emilianoagostini14/Sistema-de-Monitoreo-Electronico-para-Vehiculos/README.md

# Sistema-de-Monitoreo-Electronico-para-Vehiculos
Este repositorio contendrá los programas, archivos y diseños del proyecto integrador Sistema de Monitoreo Electronico  para Vehiculos
