emilianoagostini14/Sistema-de-Monitoreo-Electronico-para-Vehiculos/Diseños 3D/Tapa.SLDPRT

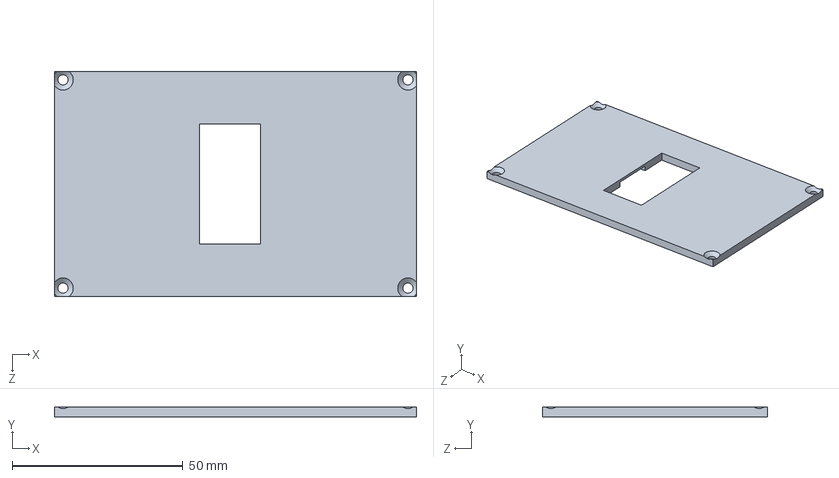
[picture p16: CAD file, 2025-11-07]
Diseños 3D/Tapa.SLDPRT
106.0 x 3.00 x 66.0 mm
