emilianoagostini14/Sistema-de-Monitoreo-Electronico-para-Vehiculos/Diseños 3D/Base.SLDPRT

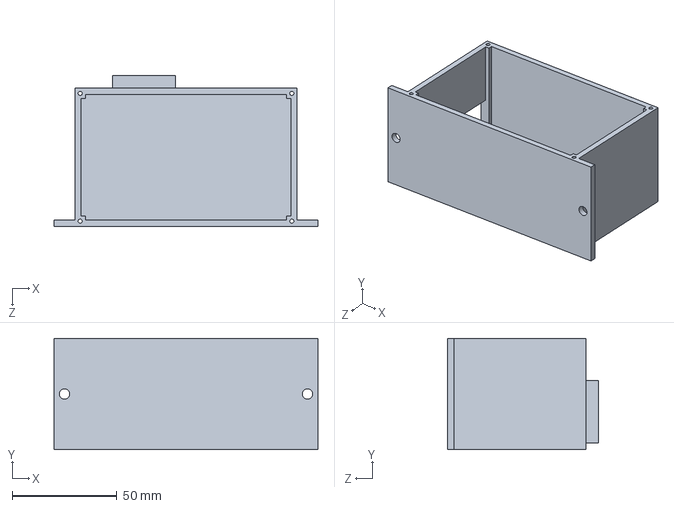
[picture p17: CAD file, 2025-11-07]
Diseños 3D/Base.SLDPRT
126.0 x 53.0 x 72.0 mm
