emilianoagostini14/Sistema-de-Monitoreo-Electronico-para-Vehiculos/(list of files, drawings)

Other design files:
Simulaciones/simulacionAdaptacionDeVoltaje.ms14
