emilianoagostini14/Sistema-de-Monitoreo-Electronico-para-Vehiculos/PCB/PCB-SistemaDeMonitoreVehicular/PCB-SistemaDeMonitoreVehicular.kicad_pcb

## KiCad design PCB/PCB-SistemaDeMonitoreVehicular/PCB-SistemaDeMonitoreVehicular.kicad_pcb (2025-11-07)

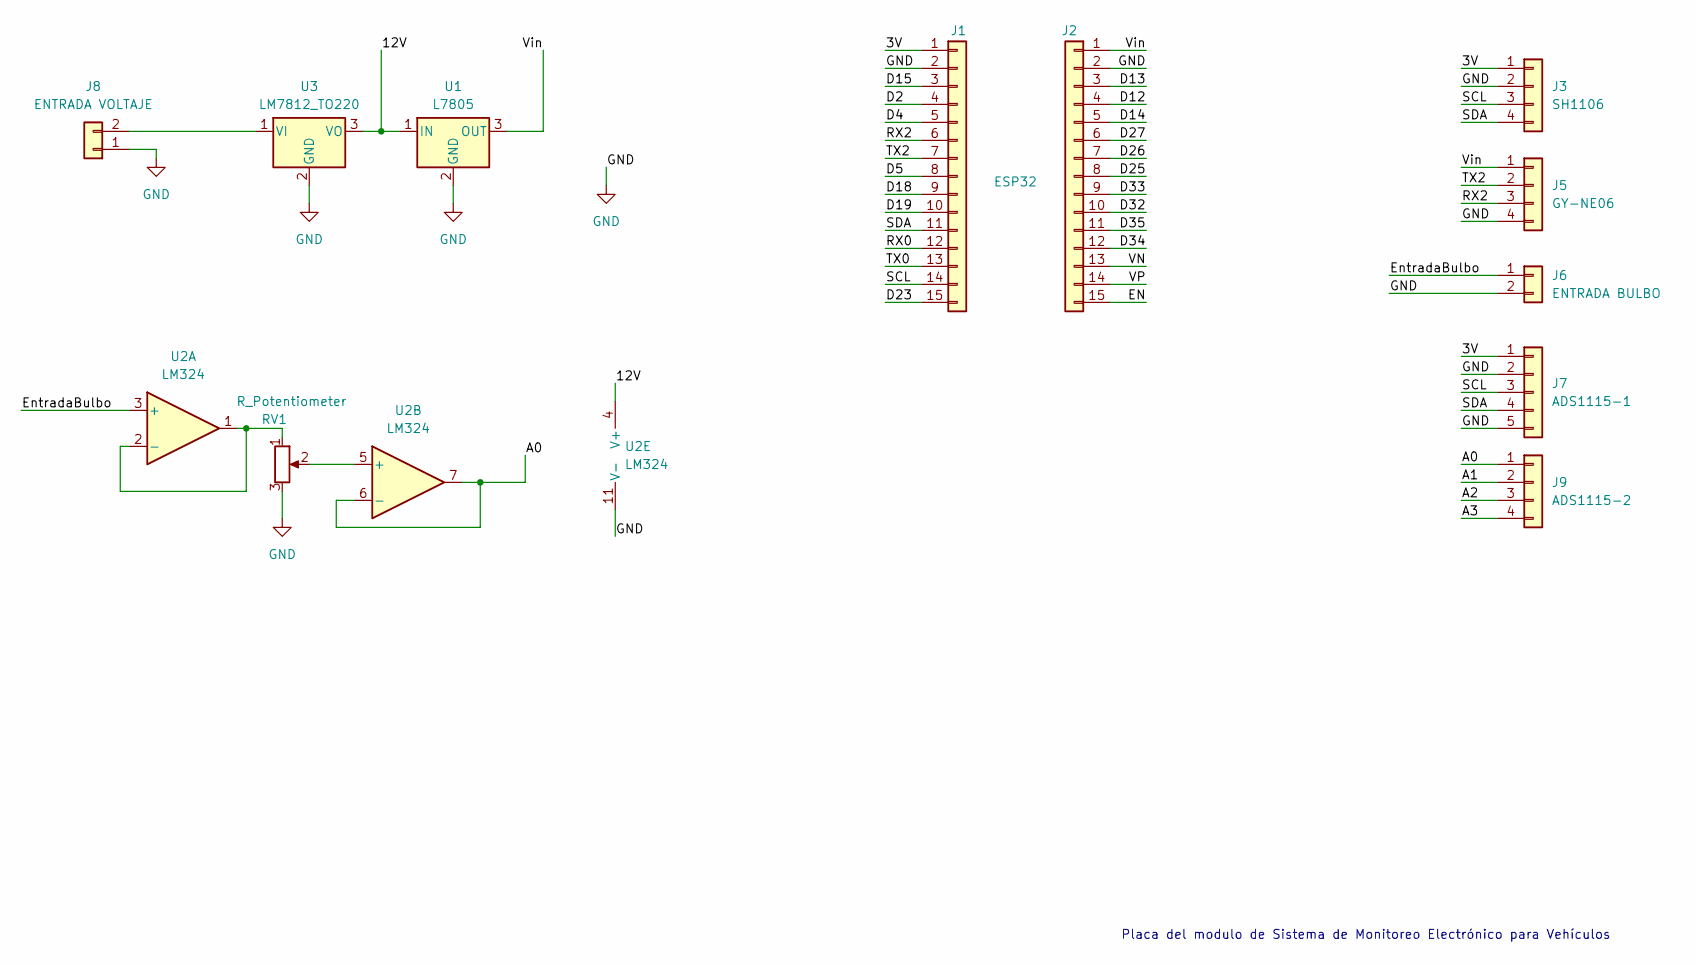
[picture p18: schematic PCB-SistemaDeMonitoreVehicular.kicad_sch]

Parts:
J1: ESP32; PinHeader_1x15_P2.54mm_Vertical
J2: Conn_01x15; PinHeader_1x15_P2.54mm_Vertical
J3: SH1106; PinHeader_1x04_P2.54mm_Vertical
J5: GY-NE06; PinHeader_1x04_P2.54mm_Vertical
J6: ENTRADA BULBO; TerminalBlock_bornier-2_P5.08mm
J7: ADS1115-1; PinHeader_1x05_P2.54mm_Vertical
J8: ENTRADA VOLTAJE; TerminalBlock_bornier-2_P5.08mm
J9: ADS1115-2; PinHeader_1x04_P2.54mm_Vertical
RV1: R_Potentiometer; Potentiometer_Bourns_3296W_Vertical
U1: L7805; TO-220-3_Vertical
U2: LM324; DIP-14_W10.16mm_LongPads
U3: LM7812_TO220; TO-220-3_Vertical

Connections:
/3V: J1.1, J3.1, J7.1
/12V: U1.1 (IN), U2.4 (V+), U3.3 (VO)
/A0: J9.1, U2.6 (-), U2.7
/A1: J9.2
/A2: J9.3
/A3: J9.4
/D2: J1.4
/D4: J1.5
/D5: J1.8
/D12: J2.4
/D13: J2.3
/D14: J2.5
/D15: J1.3
/D18: J1.9
/D19: J1.10
/D23: J1.15
/D25: J2.8
/D26: J2.7
/D27: J2.6
/D32: J2.10
/D33: J2.9
/D34: J2.12
/D35: J2.11
/EN: J2.15
/EntradaBulbo: J6.1, U2.3 (+)
/GND: J1.2, J2.2, J3.2, J5.4, J6.2, J7.2, J7.5, J8.1, RV1.3, U1.2 (GND), U2.11 (V-), U3.2 (GND)
/RX0: J1.12
/RX2: J1.6, J5.3
/SCL: J1.14, J3.3, J7.3
/SDA: J1.11, J3.4, J7.4
/TX0: J1.13
/TX2: J1.7, J5.2
/VN: J2.13
/VP: J2.14
/Vin: J2.1, J5.1, U1.3 (OUT)
unnamed: J8.2, U3.1 (VI)
unnamed: RV1.1, U2.1, U2.2 (-)
unnamed: RV1.2, U2.5 (+)

Notes on the sheet:
Placa del modulo de Sistema de Monitoreo Electrónico para Vehículos

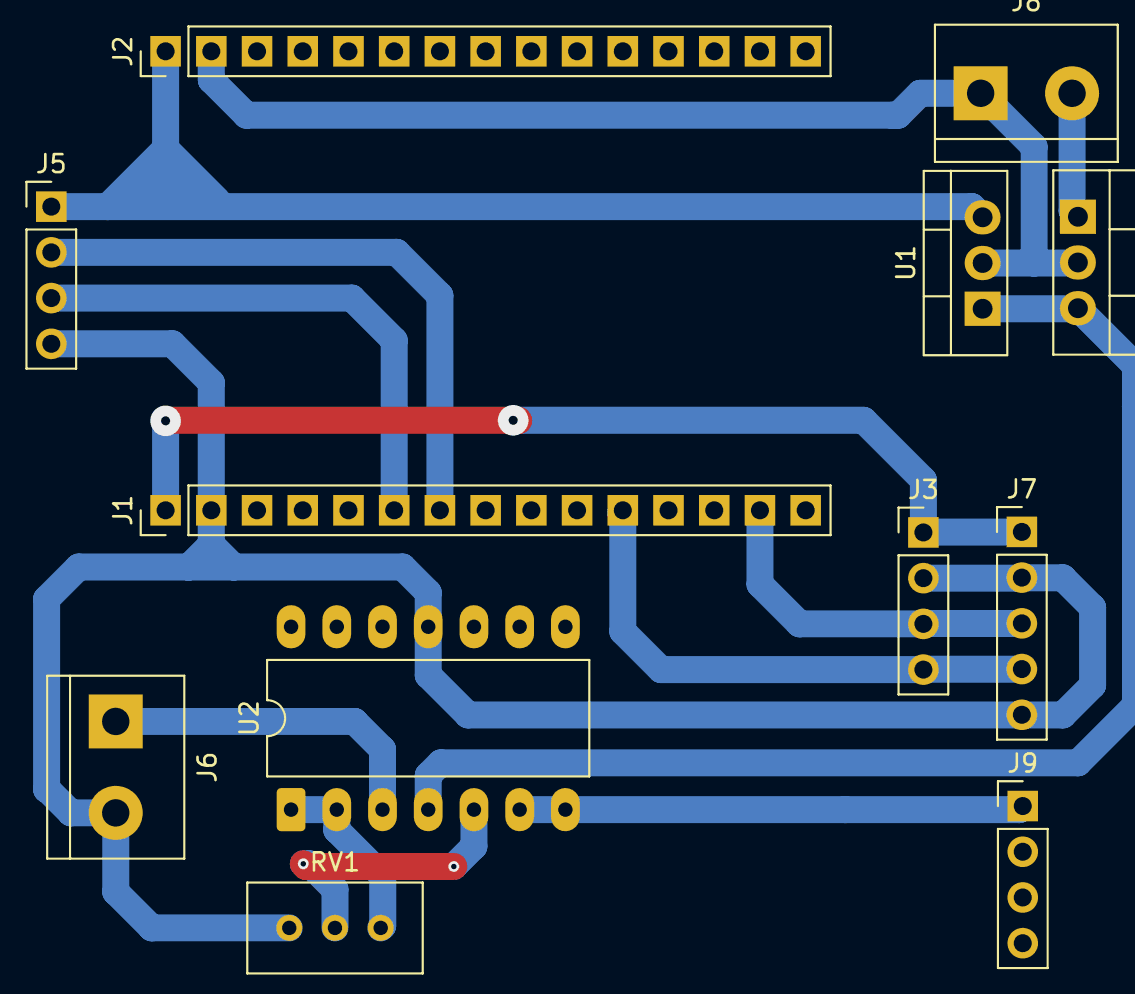
[picture p19: board PCB-SistemaDeMonitoreVehicular.kicad_pcb from above]

Board: 2 copper layers, 12 parts (0 on the bottom side), 13 nets.
